adafruit/Adafruit-STEMMA-Non-Latching-Mini-Relay-PCB/Adafruit Non-Latching Relay Breakout.brd

## EAGLE design Adafruit Non-Latching Relay Breakout.brd (2019-10-29)

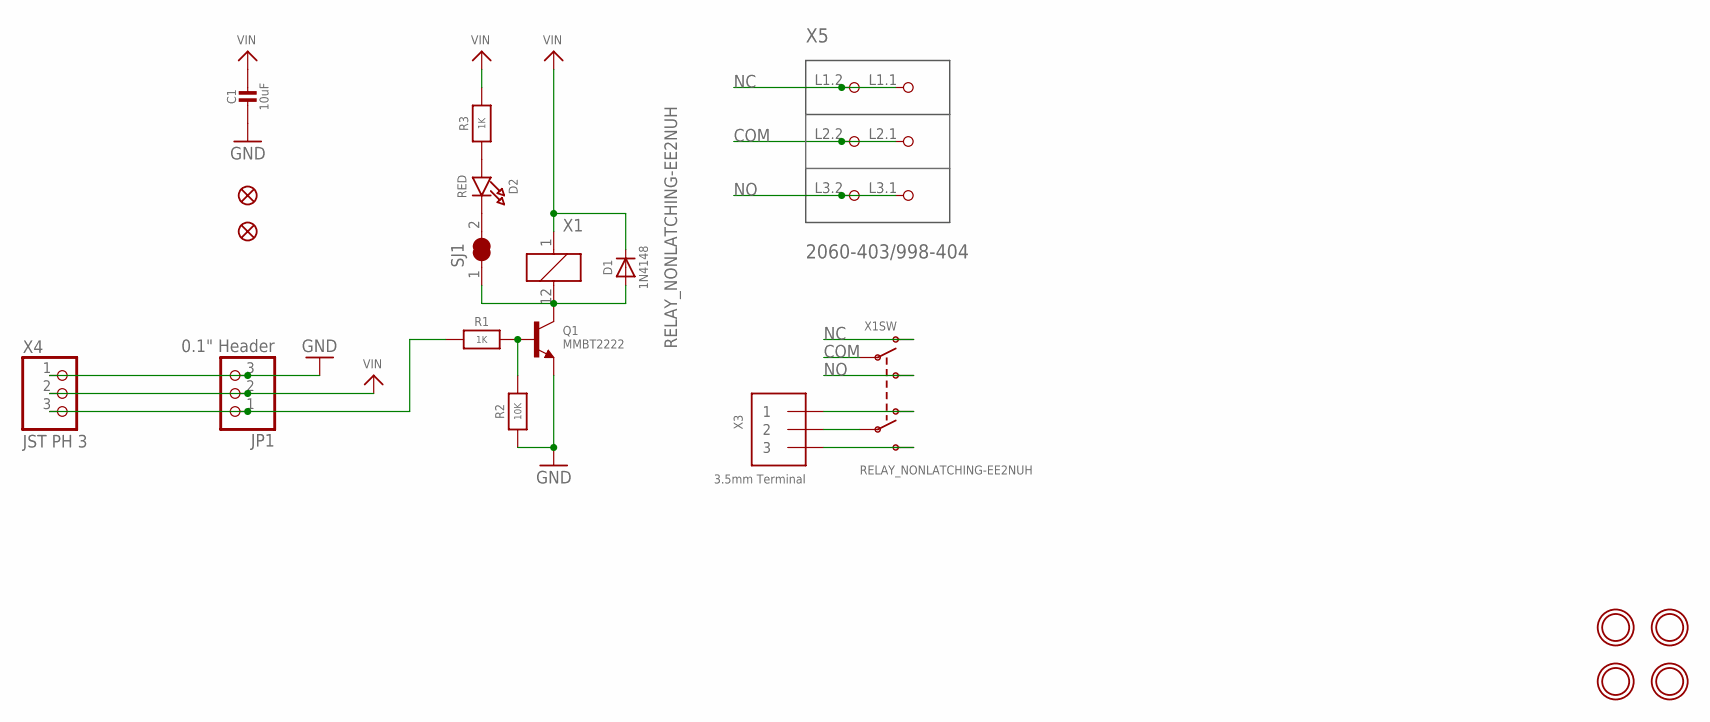
[picture p2: schematic Adafruit Non-Latching Relay Breakout.sch]

Parts:
C1: 10uF; 0805-NO
D1: 1N4148; SOD-323
D2: RED; CHIPLED_0805_NOOUTLINE
FID2, FID3: FIDUCIAL_1MM
JP1: 0.1" Header; 1X03_OVAL
Q1: MMBT2222; SOT23-R
R1, R3: 1K; 0603-NO
R2: 10K; 0603-NO
SJ1: SOLDERJUMPER_CLOSED; SOLDERJUMPER_CLOSEDWIRE
U$1, U$8, U$9, U$10: MOUNTINGHOLE2.5; MOUNTINGHOLE_2.5_PLATED
X1: RELAY_NONLATCHING-EE2NUH; RELAY_EE2_NOLATCH
X3: 3.5mm Terminal; TERMBLOCK_1X3-3.5MM
X4: JST PH 3; JSTPH3
X5: 2060-403/998-404; P-2060-403/998-404

Connections:
COM: X1.9 (P1), X5.L2.1 (P2.1), X5.L2.2 (P2.2)
GND: C1.2, JP1.3, Q1.2 (E), R2.1, X4.1
unnamed: D1.A, Q1.3 (C), SJ1.1, X1.12 (2)
unnamed: X1.3 (O2), X3.1
unnamed: X1.4 (P2), X3.2
unnamed: X1.5 (S2), X3.3
unnamed: Q1.1 (B), R1.2, R2.2
unnamed: D2.C, SJ1.2
unnamed: D2.A, R3.1
NC: X1.10 (O1), X5.L1.1 (P1.1), X5.L1.2 (P1.2)
NO: X1.8 (S1), X5.L3.1 (P3.1), X5.L3.2 (P3.2)
SIGNAL: JP1.1, R1.1, X4.3
VIN: C1.1, D1.C, JP1.2, R3.2, X1.1, X4.2

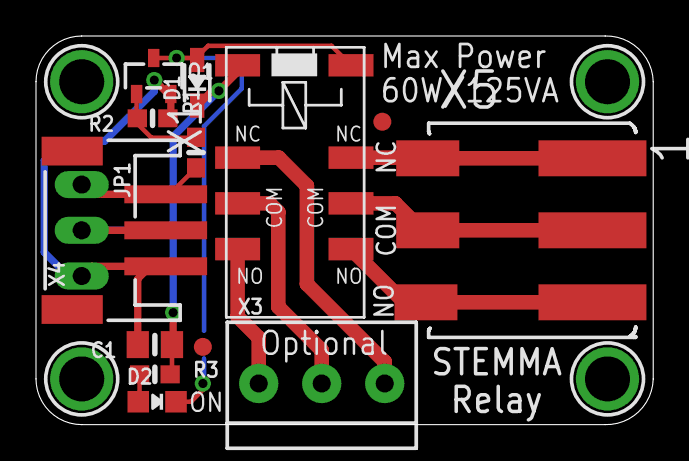
[picture p3: board Adafruit Non-Latching Relay Breakout.brd from above]

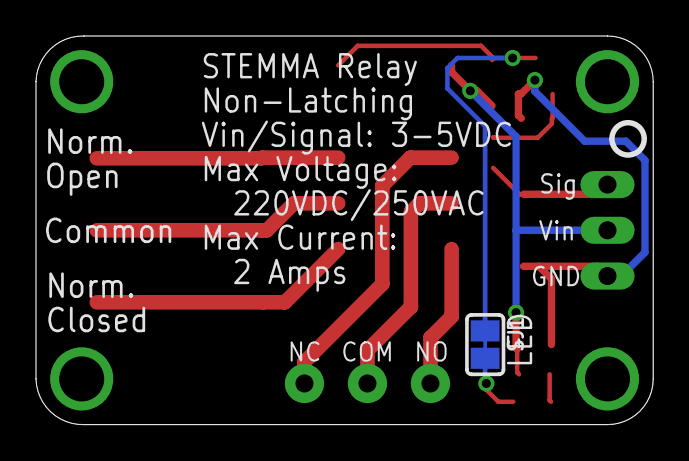
[picture p4: board Adafruit Non-Latching Relay Breakout.brd from below]

Board: 2 copper layers, 34.3 x 21.6 mm, 20 parts (2 on the bottom side), 13 nets.

Other parts of the board:
U$5: PCBFEAT-REV-040
